teovilaplana/TFG_IDPS/README.md

# TFG_IDPS
Indoor Positioning System Final Project by Teo Vilaplana
