teovilaplana/TFG_IDPS/KiCadLib/Converted/altium2kicad-conversionlog.txt

Archive:  db/1341.zip
  inflating: db/1341/Module Footprint_DWM1001.SchLib  
  inflating: db/1341/Module Library_DWM1001.PcbLib  
Loading Module Library_DWM1001.PcbLib

Loading Module Footprint_DWM1001.SchLib

Done.
Handling Module Footprint_DWM1001-SchLib/Root Entry/FileHeader.dat
Handling Module Library_DWM1001-PcbLib/Root Entry/FileHeader.dat
No unpacked .PcbDoc documents found. Trying to unpack it:
Loading Module Library_DWM1001.PcbLib

Loading Module Footprint_DWM1001.SchLib

Done.
Full: Module Library_DWM1001-PcbLib/Root Entry/DWM1001/Data.dat.bin Short: Module Library_DWM1001 Module: DWM1001
Writing to Module Library_DWM1001.pretty/DWM1001.kicad_mod
Decoding Module Library_DWM1001-PcbLib/Root Entry/DWM1001/Data.dat.bin (27658 Bytes)...
Name: DWM1001
Snippet: 480C00FFFFFFFFFFFFFFFFFFFFE50106009DEC64007F2A020000000000000000000000000000807640A08601000000000000000010000201
Arc
Snippet: 480C00FFFFFFFFFFFFFFFFFFFF00000000732600000000000094A49C00CA990000000000000000000010000201
Track
Snippet: 480C00FFFFFFFFFFFFFFFFFFFF0000000094A49C00C5BD720094A49C00CA990000000000000000000010000201
Track
Snippet: 480C00FFFFFFFFFFFFFFFFFFFFC5BD720073260000C5BD720094A49C00CA990000000000000000000010000201
Track
Snippet: 480C00FFFFFFFFFFFFFFFFFFFF0000000073260000C5BD720073260000CA990000000000000000000010000201
Track
Snippet: 480C00FFFFFFFFFFFFFFFFFFFF99802A00E070720099802A00D8099900CA990000000000000000000010000201
Track
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
92E333730316D696C7C4D4F44454C2E534E4150434F554E543D307C4D4F44454C2E4D4F44454C545950453D310004000000000000000040C340000000000000404000000000A8C25C41000000000000404000000000A8C25C4100000000349E6341000000000040C34000000000349E6341
Fill
There were no unpacked PcbDoc files found.
