teovilaplana/TFG_IDPS/Report/Lista de materiales.xlsx

Item # | Nombre | Descripción | Link | Datasheet | Link compra
1 | MDEK1001 Development Kit | Kit de desarrollo para DWM1001 (Sistema de posicionamiento UWB via TDoA) | https://www.decawave.com/product/mdek1001-deployment-kit/ | https://www.decawave.com/dwm1001dev/datasheet/ | https://www.futureelectronics.com/es/p/development-tools--rf-wireless/mdek1001-qorvo-9131369
2 | MAXM86146EVSYS | Kit de desarrollo para MAXM86146 (Modulo optico de sensores para la muñeca) | https://www.maximintegrated.com/en/products/sensors/MAXM86146EVSYS.html/ | https://datasheets.maximintegrated.com/en/ds/MAXM86146.pdf | https://www.mouser.es/ProductDetail/Maxim-Integrated/MAXM86146EVSYS?qs=7MVldsJ5UazRSVY4nlVfug%3D%3D
3 | NUCLEO-F303RE | Kit de desarrollo STM32 Nucleo-64 | a (https://www.st.com/content/st_com/en/products/evaluation-tools/product-evaluation-tools/mcu-mpu-eval-tools/stm32-mcu-mpu-eval-tools/stm32-nucleo-boards/nucleo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) | https://www.st.com/resource/en/user_manual/dm00105823-stm32-nucleo-64-boards-mb1136-stmicroelectronics.pdf | https://www.st.com/content/st_com/en/products/evaluation-tools/product-evaluation-tools/mcu-mpu-eval-tools/stm32-mcu-mpu-eval-tools/stm32-nucleo-boards/nucleo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
4 | Pantalla OLED 1.3" | Pantalla OLED SPI/I2C | https://www.adafruit.com/product/938 | https://cdn-shop.adafruit.com/datasheets/SSD1306.pdf | https://es.aliexpress.com/item/4001145494936.html
