teovilaplana/TFG_IDPS/Schematics/PDF/wearable.pdf

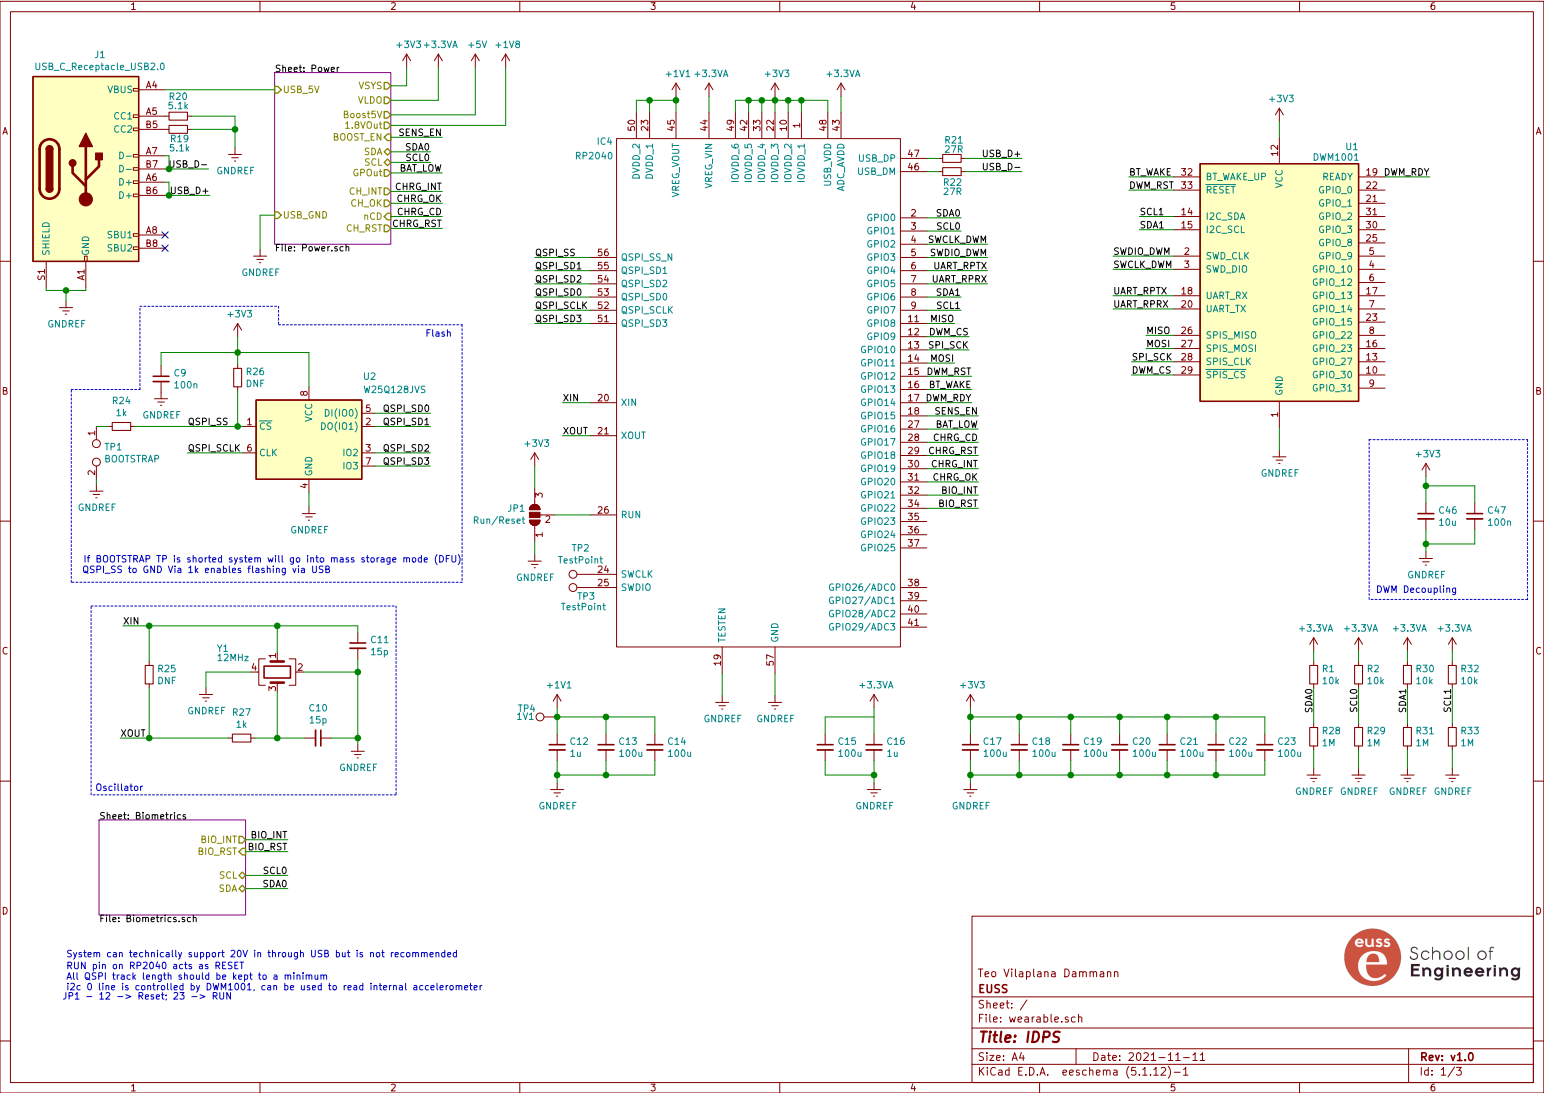
[picture p1: page 1]

1 IOVDD_2 10 GPIO8 11 GPIO9 12 GPIO10 13 GPIO11 14 GPIO12 15 GPIO13 16 GPIO14 17 GPIO15 18 TESTEN 19 GPIO0 2 XIN 20 XOUT 21 IOVDD_3 22 DVDD_1 23 SWCLK 24 SWDIO 25 RUN 26 GPIO16 27 GPIO17 28 GPIO18 29 GPIO1 3 GPIO19 30 GPIO20 31 GPIO21 32 IOVDD_4 33 GPIO22 34 GPIO23 35 GPIO24 36 GPIO25 37 GPIO26/ADC0 38 GPIO27/ADC1 39 GPIO2 4 GPIO28/ADC2 40 GPIO29/ADC3 41 IOVDD_5 42 ADC_AVDD 43 VREG_VIN 44 VREG_VOUT 45 USB_DM 46 USB_DP 47 USB_VDD 48 IOVDD_6 49 GPIO3 5 DVDD_2 50 QSPI_SD3 51 QSPI_SCLK 52 QSPI_SD0 53 QSPI_SD2 54 QSPI_SD1 55 QSPI_SS_N 56 GND 57 GPIO4 6 GPIO5 7 GPIO6 8 GPIO7 9

Flash QSPI_SS to GND Via 1k enables flashing via USB

If BOOTSTRAP TP is shorted system will go into mass storage mode (DFU) JP1 - 12 -> Reset; 23 -> RUN

System can technically support 20V in through USB but is not recommended Oscillator

RUN pin on RP2040 acts as RESET
All QSPI track length should be kept to a minimum
i2c 0 line is controlled by DWM1001, can be used to read internal accelerometer

Teo Vilaplana Dammann
File: wearable.sch Sheet: / EUSS

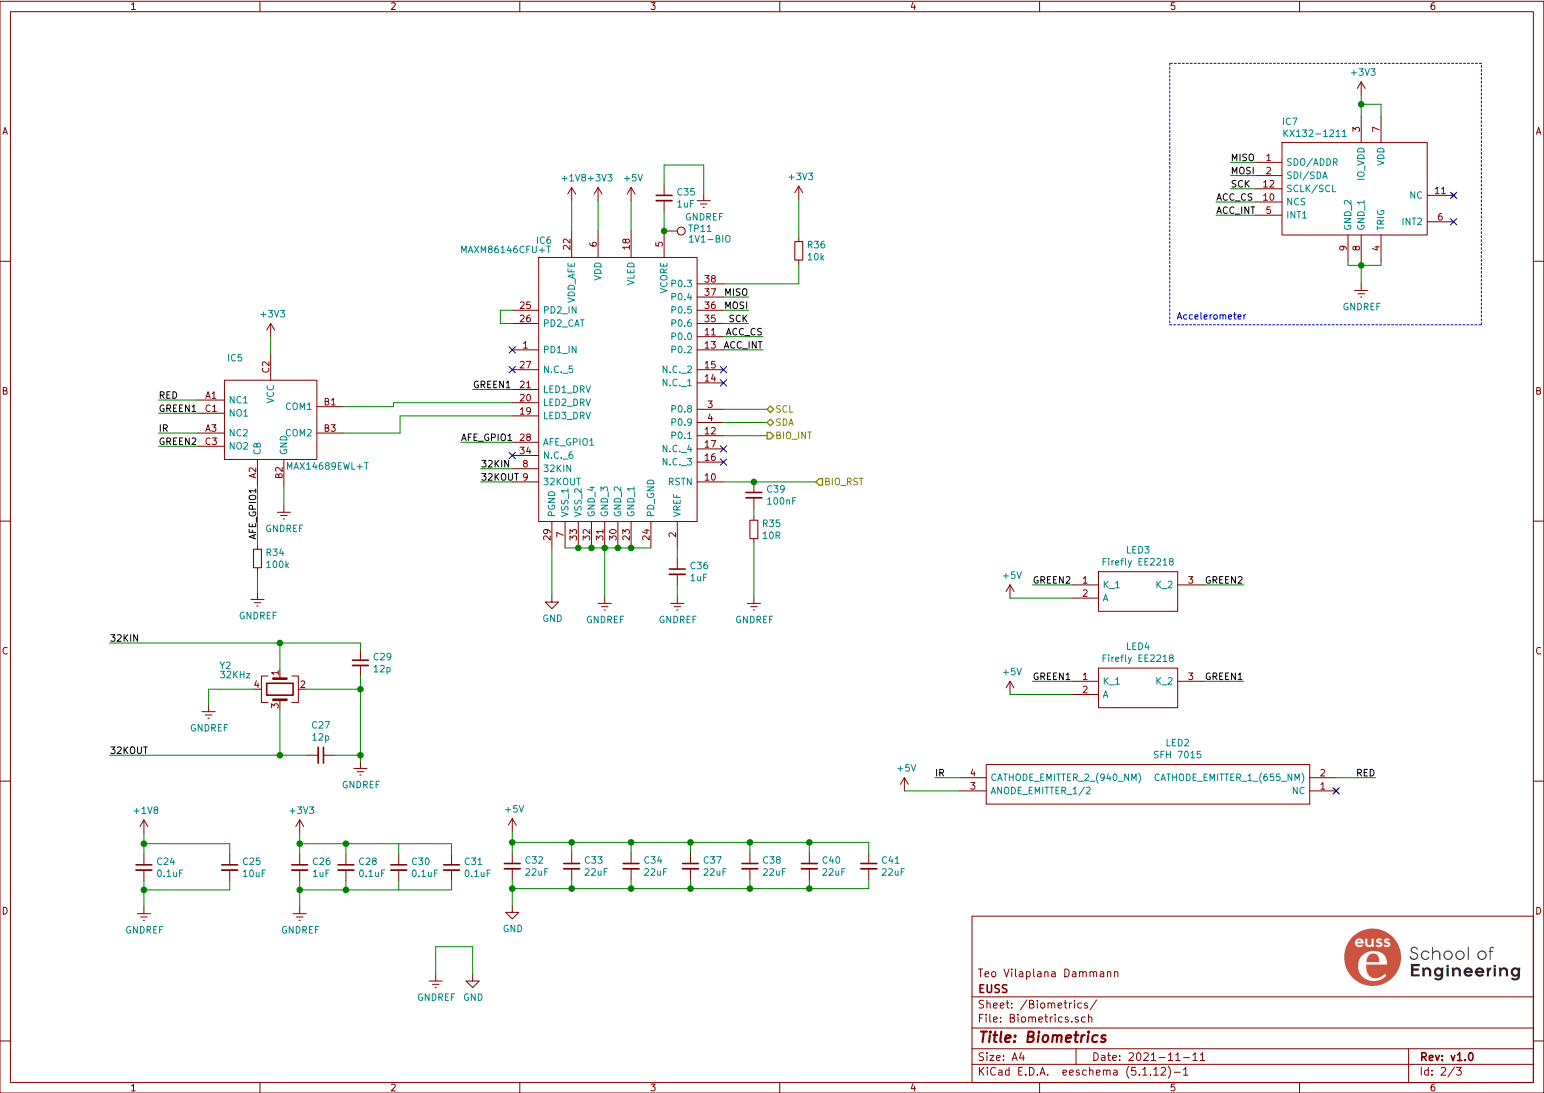
[picture p2: page 2]

Teo Vilaplana Dammann GND

File: Biometrics.sch Sheet: /Biometrics/ EUSS

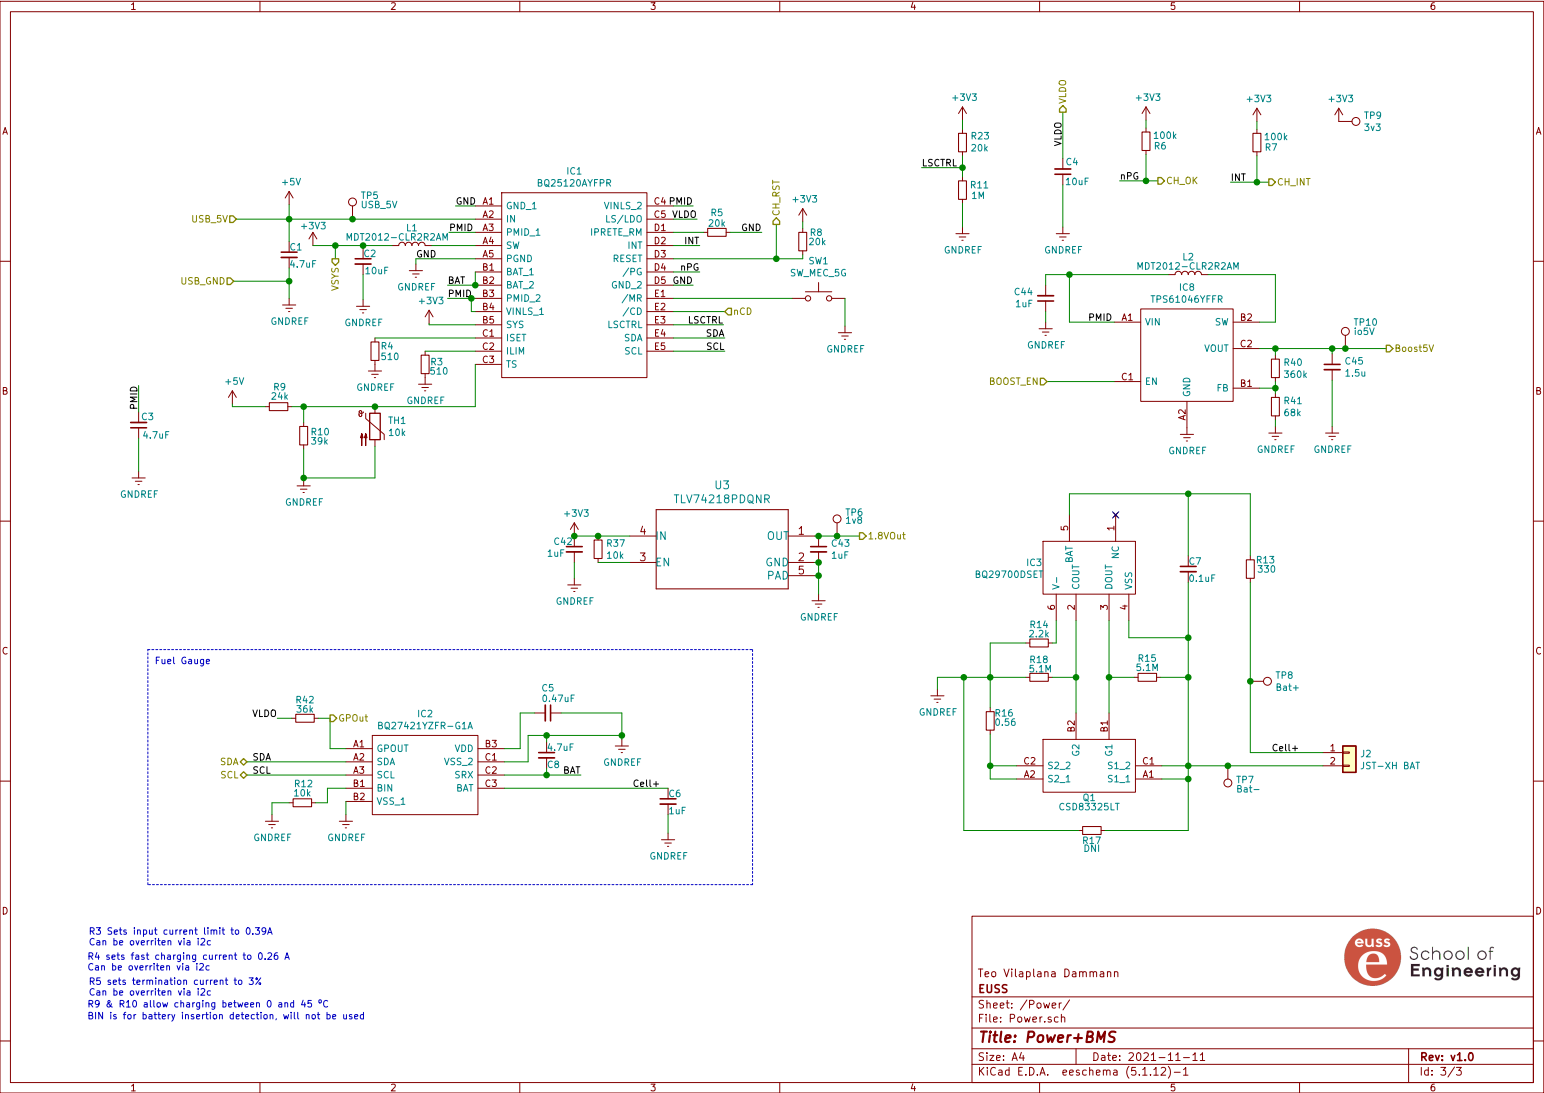
[picture p3: page 3]

R3 Sets input current limit to 0.39A Can be overriten via i2c Fuel Gauge

R4 sets fast charging current to 0.26 A Can be overriten via i2c R5 sets termination current to 3%

Teo Vilaplana Dammann
File: Power.sch Sheet: /Power/ EUSS

Can be overriten via i2c BIN is for battery insertion detection, will not be used
R9 & R10 allow charging between 0 and 45 ºC

Id: 3/3 Title: Power+BMS
