teovilaplana/TFG_IDPS/(list of files, drawings)

Other design files:
KiCadLib/Converted/Module Footprint_DWM1001.SchLib
KiCadLib/Converted/Module Library_DWM1001.PcbLib
