teovilaplana/TFG_IDPS/Schematics/wearable/Power.sch

## KiCad design Schematics/wearable/Power.sch (2021-11-12, an earlier design)

Schematic: Power.sch

Parts:
C1, C3, C8: 4.7uF
C2, C4: 10uF
C5: 0.47uF
C6: 1uF
C7: 0.1uF
IC1: BQ25120AYFPR; BGA25C40P5X5_247X253X50; Manufacturer_Part_Number BQ25120AYFPR; Mouser Part Number 595-BQ25120AYFPR
IC2: BQ27421YZFR-G1A; BGA9C50P3X3_162X158X62; Manufacturer_Part_Number BQ27421YZFR-G1A; Mouser Part Number 595-BQ27421YZFR-G1A
J1: JST-XH BAT; JST_XH_S2B-XH-A_1x02_P2.50mm_Horizontal
L1: MDT2012-CLR2R2AM
Q1: CSD83325LT; BGA6C65P2X3_111X216X22; Manufacturer_Part_Number CSD83325LT; Mouser Part Number 595-CSD83325LT
R1, R2: 10k
R3, R4: 510
R5, R8, R12: 20k
R6, R7: 100k
R9: 24k
R10: 39k
R11: 1M
R13: 330
R14: 2.2k
R15, R18: 5.1M
R16: 0.56
R17: DNI
R19: 36k
SW1: SW_MEC_5G
TH1: 10k
U1: BQ29702DSET; DSE0006A

Notes on the sheet:
R3 Sets input current limit to 0.39A Can be overriten via i2c
R4 sets fast charging current to 0.26 A Can be overriten via i2c
R9 & R10 allow charging between 0 and 45 ºC
R5 sets termination current to 3% Can be overriten via i2c
28/10/2021
