teovilaplana/TFG_IDPS/Schematics/wearable/Power/Power.sch

## KiCad design Schematics/wearable/Power/Power.sch (2021-11-09, an earlier design)

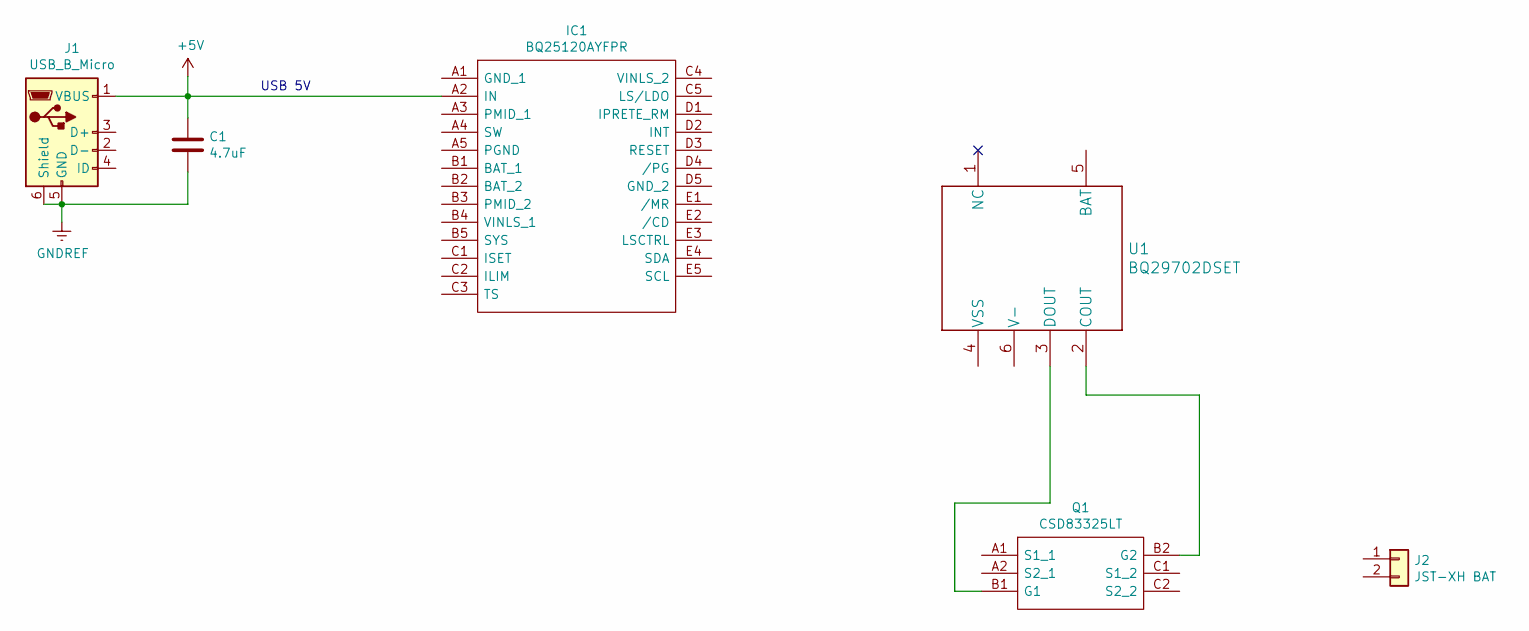
[picture p4: schematic Power.sch]

Parts:
C1: 4.7uF
IC1: BQ25120AYFPR; BGA25C40P5X5_247X253X50; Manufacturer_Part_Number BQ25120AYFPR; Mouser Part Number 595-BQ25120AYFPR
J1: USB_B_Micro
J2: JST-XH BAT; JST_XH_S2B-XH-A_1x02_P2.50mm_Horizontal
Q1: CSD83325LT; BGA6C65P2X3_111X216X22; Manufacturer_Part_Number CSD83325LT; Mouser Part Number 595-CSD83325LT
U1: BQ29702DSET; DSE0006A

Connections:
+5V: C1.1, IC1.A2 (IN), J1.1 (VBUS)
GNDREF: C1.2, J1.5 (GND), J1.6 (Shield)
unnamed: Q1.B1 (G1), U1.3 (DOUT)
unnamed: Q1.B2 (G2), U1.2 (COUT)

Notes on the sheet:
USB 5V
