teovilaplana/TFG_IDPS/Doc/Mainboard/Power/Power guide.txt

https://www.maximintegrated.com/en/design/design-tools/power-supply-cookbook.html
