teovilaplana/TFG_IDPS/Report/RP2040 GPIO usage.xlsx

RP2040 | PIN | Usage | IN/OUT
 | GPIO0 | SDA 0 | n/a
 | GPIO1 | SCL 0 | n/a
 | GPIO2 | SWD Programmer CLK | n/a
 | GPIO3 | SWD Programmer IO | n/a
 | GPIO4 | UART TX | out
 | GPIO5 | UART RX | in
 | GPIO6 | SDA 1 | n/a
 | GPIO7 | SCL 1 | n/a
 | GPIO8 | SPI 1 RX | in
 | GPIO9 | SPI 1 nCS | out
 | GPIO10 | SPI 1 SCK | n/a
 | GPIO11 | SPI 1 TX | out
 | GPIO12 | DWM1001 Reset | out
 | GPIO13 | BT wake up | out
 | GPIO14 | DWM Ready interrupt | in
 | GPIO15 | Sensor boost converter enable | out
 | GPIO16 | Battery low interrupt | in
 | GPIO17 | Charger Chip Disable | out
 | GPIO18 | Charger Reset | out
 | GPIO19 | Charger Fault interrupt | in
 | GPIO20 | Power Good Interrupt | in
 | GPIO21 | Biometrics interrupt | in
 | GPIO22 | Biometrics reset | out
 | GPIO23
 | GPIO24
 | GPIO25
 | GPIO26
 | GPIO27
 | GPIO28
 | GPIO29
