teovilaplana/TFG_IDPS/(commit log)

2021-10-28 Created and finished schematic for power and BMS
    [Power.sch]
2021-10-28 Added library for DWM1001
    [Module Footprint_DWM1001-SchLib.sch, Module Footprint_DWM1001.SchLib, Module Library_DWM1001.PcbLib]
2021-10-28 Updated page layout
    [Power.sch, wearable.sch]
2021-10-29 updated ic references
    [Power.sch]
2021-11-01 Added documentation for RP2040
    [wearable.sch]
2021-11-11 V1 Schematics complete
    [Biometrics.sch, Power.sch, RP2040 GPIO usage.xlsx, wearable.sch]
2021-11-12 updated schematics
    [Power.sch]
